Computer-Aided-Validation-Laboratory/halleffectsensors/hardware/circuit_picture_2.jpeg

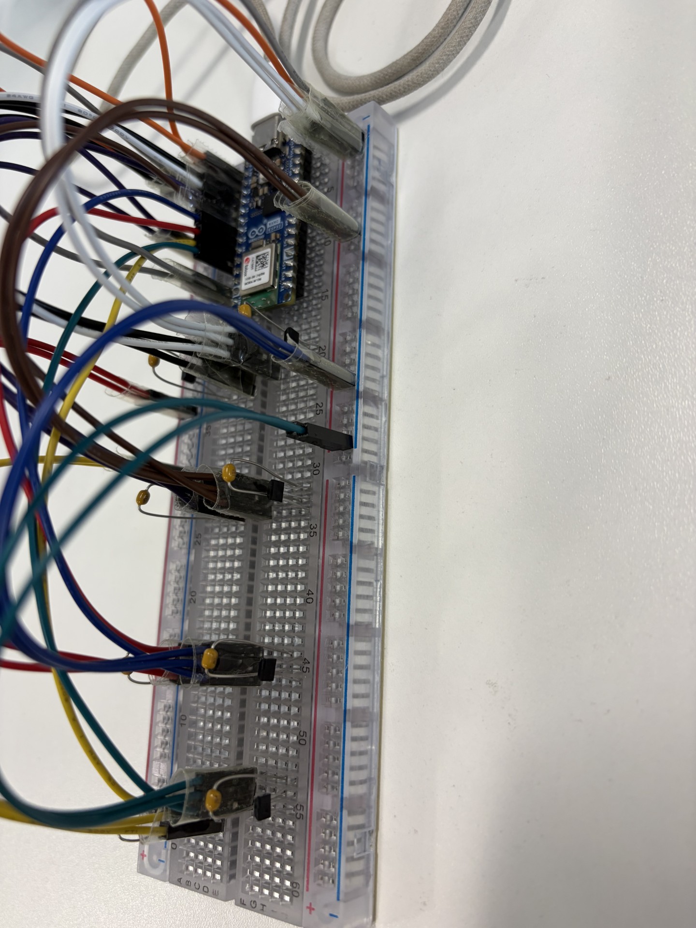
hardware/circuit_picture_2.jpeg
