Computer-Aided-Validation-Laboratory/halleffectsensors/hardware/circuit_picture_1.jpeg

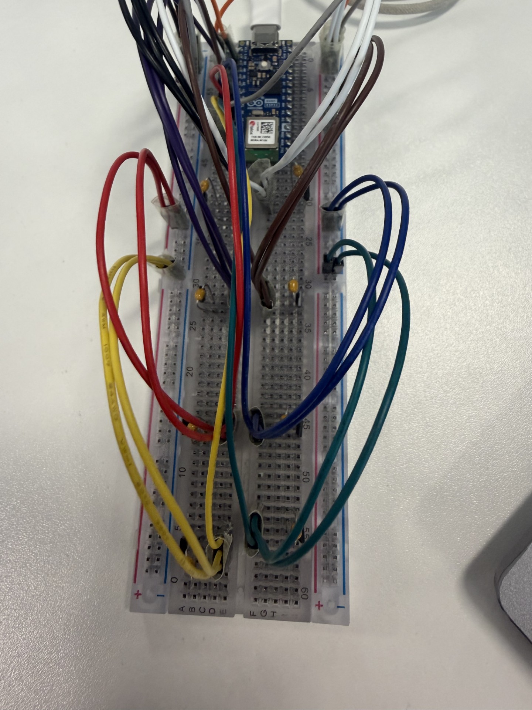
hardware/circuit_picture_1.jpeg
