Computer-Aided-Validation-Laboratory/halleffectsensors/software/interpolation_methods/overview.md

# Interpolation Methods

The field will eventually be visualised using a live feed from a National Instruments (NI) Data Aquisition (DAQ) system feeding into MatchID. In the mean time the fields used for calibration and otherwise are being visualised in python using the `griddata()` method from `scipy.interpolate` to interpolate the points. This not currently an exact method however just works to check the software is interpreting the sensor data and the coordinates of the sensors from the jsons correctly. 

The code for this is found in `plot.py` and it will produce an .mp4 file showing the field distribution across the sensor array. This method uses a cubic interpolation.
