Computer-Aided-Validation-Laboratory/halleffectsensors/hardware/circuit_design/intial_circuit.md

# Initial Circuit Design

The array must start with only a few sensors all facing in 1 direction. The initial array is put together using the sensors and capacitors and an Arduino Nano on a breadboard. This array is used to develop and validate calibration software which can be used on the extended array when it is made.

## Initial circuit schematic



This basic idea is scaled up for larger arrays but the concept is consistent throughout any array
