Computer-Aided-Validation-Laboratory/halleffectsensors/hardware/circuit_design/PCB_designs.md

not on this yet but will put PCB thoughts in here
