Computer-Aided-Validation-Laboratory/halleffectsensors/software/src/python_code/3D_array/cal_9-sensor.png

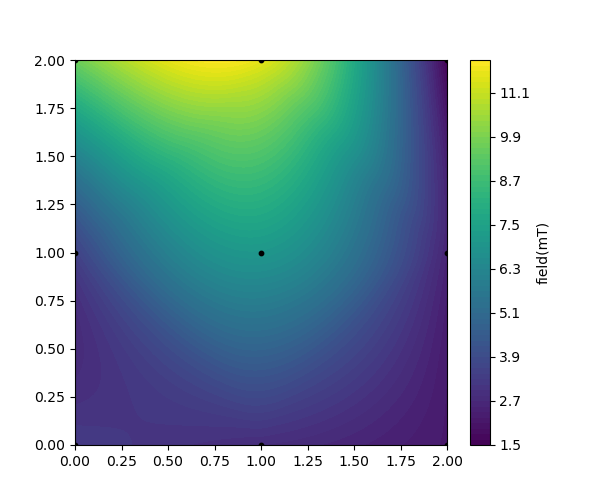
software/src/python_code/3D_array/cal_9-sensor.png
