Computer-Aided-Validation-Laboratory/halleffectsensors/software/src/python_code/3D_array/maps/cal_11-diff.png

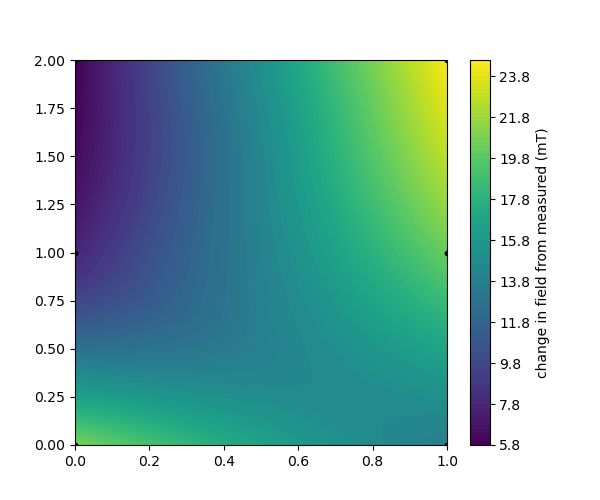
software/src/python_code/3D_array/maps/cal_11-diff.png
