Computer-Aided-Validation-Laboratory/halleffectsensors/software/src/python_code/example_plot.png

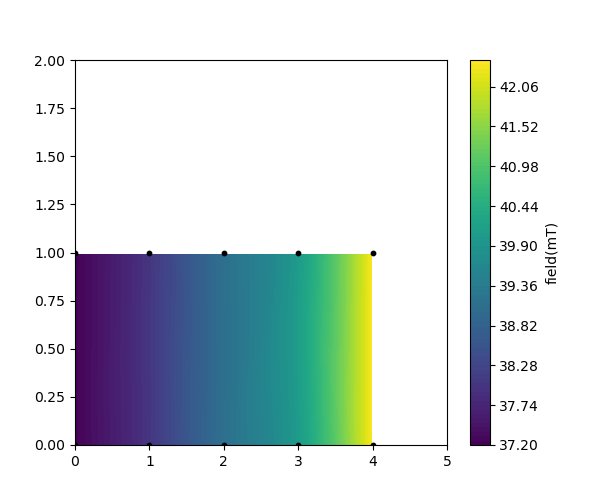
software/src/python_code/example_plot.png
