Computer-Aided-Validation-Laboratory/halleffectsensors/hardware/Sensor Array mesh.FCStd

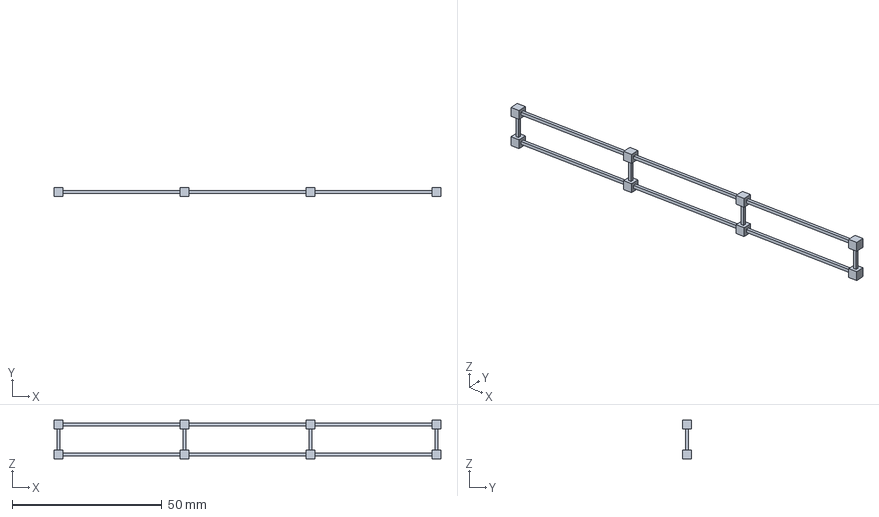
[picture p7: CAD file, 2026-10-21]
hardware/Sensor Array mesh.FCStd
129.1 x 3.00 x 13.0 mm
