Computer-Aided-Validation-Laboratory/halleffectsensors/hardware/cube.FCStd

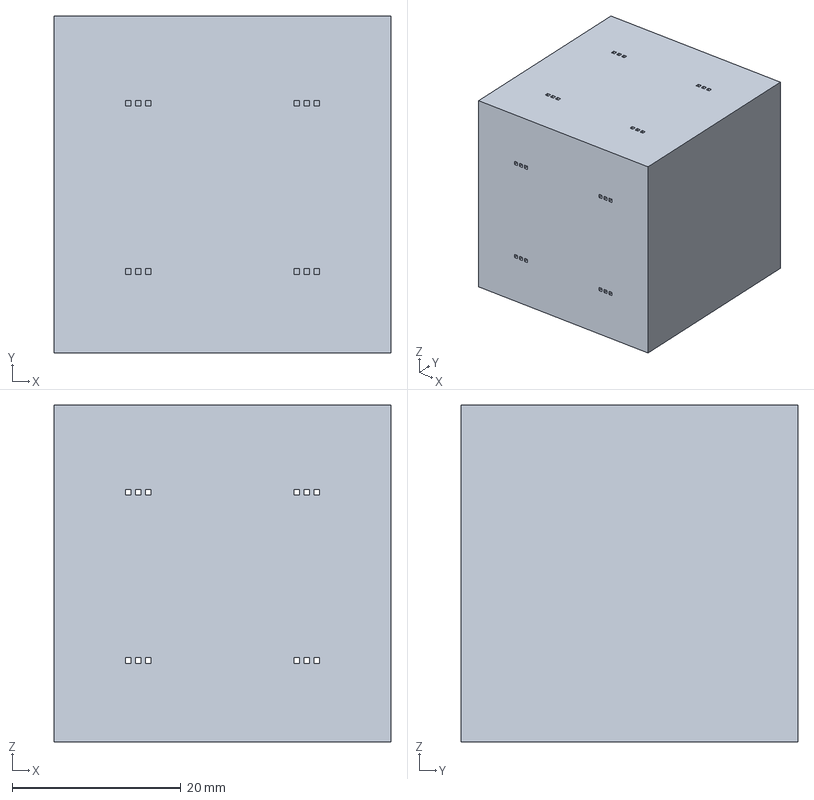
[picture p8: CAD file, 2026-10-21]
hardware/cube.FCStd
40.0 x 40.0 x 40.0 mm
