Computer-Aided-Validation-Laboratory/halleffectsensors/hardware/notches.FCStd

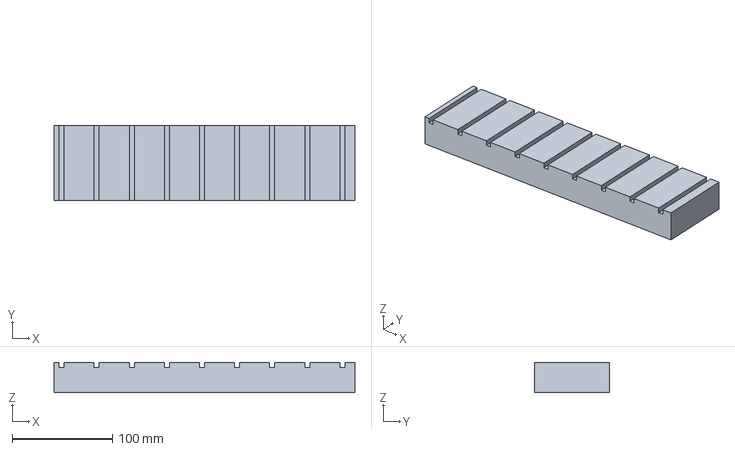
[picture p9: CAD file, 2026-10-21]
hardware/notches.FCStd
300.0 x 75.0 x 30.0 mm
