Computer-Aided-Validation-Laboratory/halleffectsensors/hardware/hall-sensors-storage.FCStd

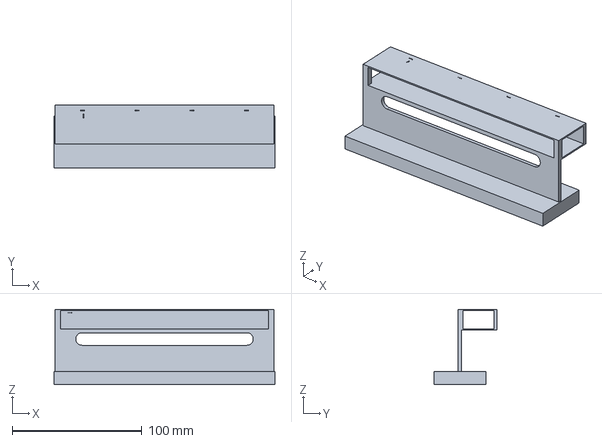
[picture p10: CAD file, 2026-10-21]
hardware/hall-sensors-storage.FCStd
170.0 x 48.8 x 58.0 mm
