Computer-Aided-Validation-Laboratory/halleffectsensors/hardware/new_shelf.FCStd

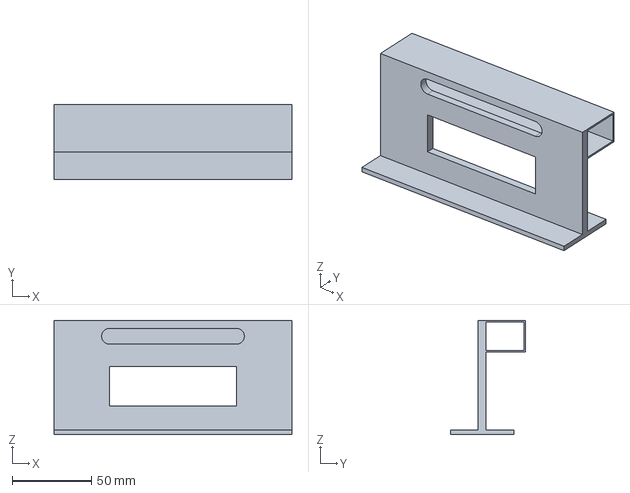
[picture p11: CAD file, 2026-10-21]
hardware/new_shelf.FCStd
150.0 x 47.5 x 72.0 mm
