Computer-Aided-Validation-Laboratory/halleffectsensors/hardware/Mini-Mera_setup_CAD.FCStd

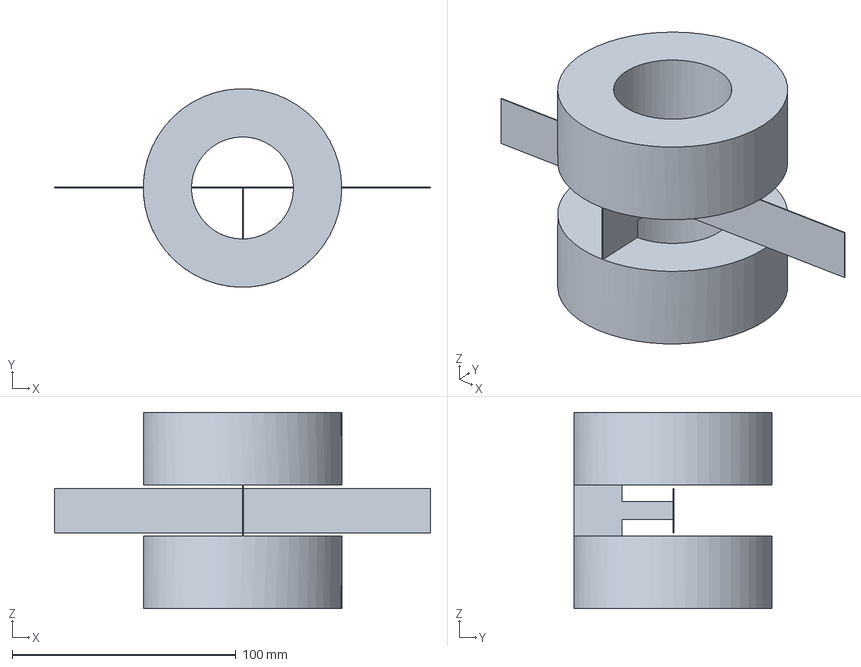
[picture p12: CAD file, 2026-10-21]
hardware/Mini-Mera_setup_CAD.FCStd
168.1 x 88.7 x 87.7 mm
