Computer-Aided-Validation-Laboratory/halleffectsensors/hardware/sensor_array_on_back.FCStd

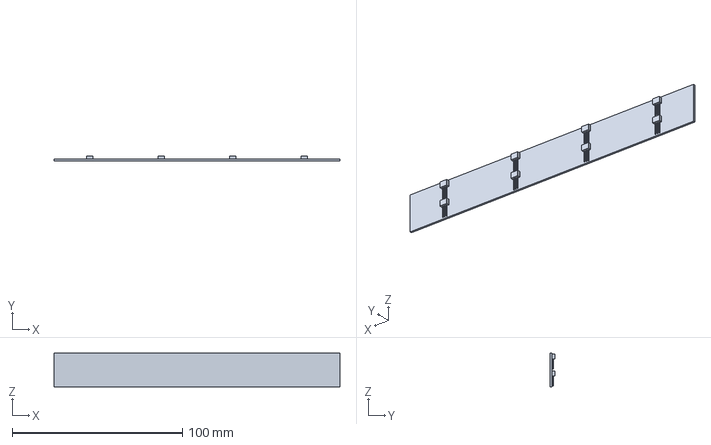
[picture p13: CAD file, 2026-10-21]
hardware/sensor_array_on_back.FCStd
168.1 x 2.65 x 19.9 mm
