Computer-Aided-Validation-Laboratory/halleffectsensors/hardware/sensor_board.FCStd

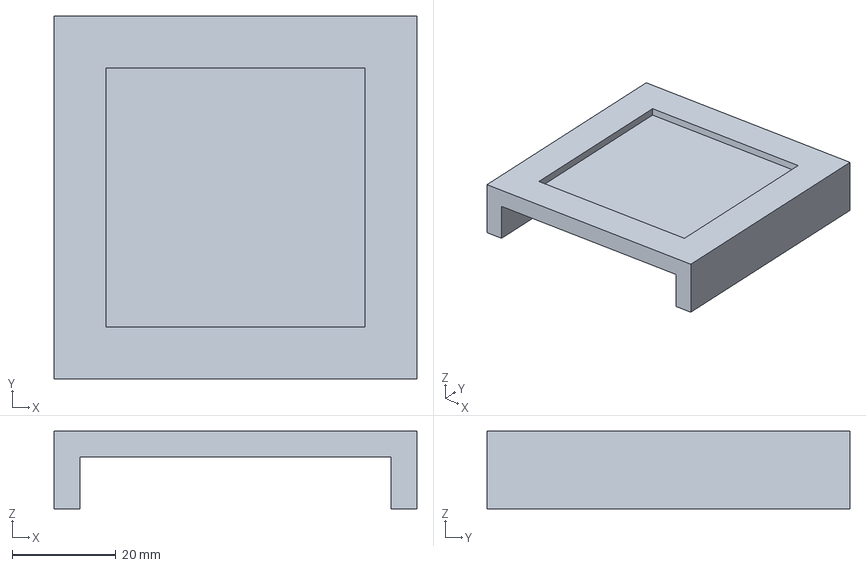
[picture p14: CAD file, 2026-10-21]
hardware/sensor_board.FCStd
70.0 x 70.0 x 15.0 mm
