Computer-Aided-Validation-Laboratory/halleffectsensors/hardware/calibration_tests.md

keep a log of the calibration tests done so far (what magnets were used, how did the test go, what setup was being calibrated and what results tell me, etc...)

so far done two, the FUJUKEN one that didnt really work and the Mini-mera one that also didnt work

and then do calibration technique plans moving forward
