Computer-Aided-Validation-Laboratory/halleffectsensors/software/src/python_code/1D_array/nulls.py

''' calculates the null voltage, associated uncertainty and the standard deviation of
each sensor in the array'''

from pathlib import Path
import numpy as np
import pandas as pd
from read import read_data

class Nulls:
    '''
    class for calculating the null voltage, standard deviations and associated uncertainties of each sensor
    measurements. 

    Attributes:
        number (int): the number of sensors in the array
        port (str): the computer port that the array is connected to
        vcc (float): the value of the VCC of the Arduino
        filename (str): the name that the data will be stored under
        vcc_un (float): the associated uncertainty with the reading of the vcc of the Arduino
        bits (int): the bit depth of the microcontroller
        samples (int): how many samples are read to get the values for null voltage and standard deviation

    Methods:
        find_params() -> None: 
            reads in the data and calculates the standard deviation of each sensor
            as well as the null voltages
        find_uncertainties_in_null() -> None:
            calculates the uncertainty associated with each calculation for null voltage
            that was just done.
        save_values() -> None:
            saves null voltages, uncertainties and standard deviations in csvs so that they can be 
            accessed for the next calibration step and for data conversion.
    '''
    def __init__(self, number: int, port: str, vcc: float,
                filename: str, vcc_un: float, bits: int, samples: int = 400):
        self.number = number
        self.port = port
        self.vcc = vcc
        self.vcc_uncertainty = vcc_un
        self.bits = bits
        self.filename = filename
        self.samples = samples

        self.levels = ((2**self.bits)-1)

        self.calibration_df = None
        self.null_values = None
        self.stds = None
        self.uncertainties_in_null = None
        self.null_frame = None
        self.std_frame = None

        self.find_params()

    def find_params(self) -> None:
        '''
        reads in the data and calculates the standard deviation of each sensor
        as well as the null voltages
        Args:
            None
        Returns:
            None
        '''

        self.calibration_df = read_data(self.port, self.filename, self.samples)
        self.null_frame = pd.DataFrame(np.zeros((2, self.number)), dtype = float)
        self.null_values = [0]*self.number
        self.stds = [0]*self.number

        for i in range(self.number):
            mean_entry = (self.calibration_df[self.calibration_df.columns[i+1]]).mean()
            self.null_values[i] = mean_entry * self.vcc / self.levels
            self.stds[i] = (self.calibration_df[self.calibration_df.columns[i+1]]).std(ddof=1)

        self.find_uncertainties_in_null()

    def find_uncertainties_in_null(self)-> None:
        '''
        this method calculates the uncertainty in each measurement of the null voltage
        Args:
            None
        Returns:
            None
        '''
        self.uncertainties_in_null = [0]*self.number
        count_uncertainty = 1
        uncertainty_in_vcc = (self.vcc_uncertainty/self.vcc)**2
        uncertainty_in_bits = (1/(self.levels/2))

        for i in range(self.number):
            average_sensor_reading = (self.calibration_df[self.calibration_df.columns[i+1]]).mean()
            uncertainty_in_reading = ((np.sqrt((count_uncertainty)**2+(self.stds[i])**2))/average_sensor_reading)**2
            rooted = np.sqrt(uncertainty_in_reading+uncertainty_in_vcc+(uncertainty_in_bits**2))
            self.uncertainties_in_null[i] = (rooted*self.null_values[i])

        self.save_values()

    def save_values(self) -> None:
        '''
        this method stores the values of the null voltages and their uncertainties
        as well as the values of the standard deviation of each sensor.
        Args:
            None
        Returns:
            None
        '''
        self.null_frame.iloc[0] = self.null_values
        self.null_frame.iloc[1] = self.uncertainties_in_null

        self.std_frame = pd.DataFrame(np.zeros((1, self.number)), dtype = float)
        self.std_frame.iloc[0] = self.stds

        file_dir = (Path(__file__).parent)
        output_file_nulls = file_dir/'nulls.csv'
        output_file_stds = file_dir/'stds.csv'

        self.null_frame.to_csv(output_file_nulls, index = False)
        self.std_frame.to_csv(output_file_stds, index = False)

if __name__ == "__main__":
    x = Nulls(number = 6 ,port = '/dev/ttyUSB0', vcc = 6.144,
          filename = 'nulls_1_new_circuit.csv', vcc_un = 0.005, bits = 15, samples = 400)
