Computer-Aided-Validation-Laboratory/halleffectsensors/software/src/python_code/3D_array/func.py

'''reads the data in from the Arduino'''
import json
import csv
from pathlib import Path
import time
import serial
import pandas as pd
import numpy as np

def read_data(port: str, filename: str, samples: int = 400) -> None:
    '''
    method for reading data from the sensor array from the Arduino. uses the
    serial library to read in the data, opens a csv and stores the data in
    that csv.
    Args:
        port (str): the computer port that the sensor array is connected to
        filename (str): the name of the file that the data is stored under
        samples (int): how many data samples are read in
    Returns:
        None
    '''
    ser = serial.Serial(port, 115200)
    ser.reset_input_buffer()
    time.sleep(2)
    script_dir = Path(__file__).parent/'calib_data'
    csv_file = script_dir / filename

    with open(csv_file, 'w', newline = '', encoding = 'utf-8') as csvfile:
        writer = csv.writer(csvfile)

        while True:
            raw = ser.readline().decode("utf-8", errors="ignore").strip()

            if "time_ms" in raw:
                header = raw
                break

        header = header[header.find("time_ms"):]
        header = header.replace('\x00', '').strip()
        writer.writerow(header.split(","))

        samples_taken = 0

        while samples_taken < samples:
            line = ser.readline().decode().strip()
            if line:
                values = line.split(',')
                writer.writerow(values)
                print(values)

                samples_taken += 1

    ser.close()

    df = pd.read_csv(csv_file, skipinitialspace=True)
    return df

def split_data(port: str, filename: str, samples: int, input_json: json) -> pd.DataFrame:
    '''
    method that imports a json file containing the information about each sensor. uses
    this information to sort through the columns of the incoming data and separate it
    depending on the direction the sensor faced (found in the .json). Runs the method
    above (`read_data`) so that when this method is called both will run
    Args:
        port (str): the computer port that the sensor array is connected to
        filename (str): the name of the csv file that the data that is read in is
            stored in
        samples (int): the number of samples taken
        input_json (json): contains all the input information of the sensor array being used
    Returns:
        x_data (pd.DataFrame): the data frame containing all the data coming in from
            sensors facing in the 'x' direction
        y_data (pd.DataFrame):the data frame containing all the data coming in from
            sensors facing in the 'y' direction
        z_data (pd.DataFrame):the data frame containing all the data coming in from
            sensors facing in the 'z' direction
        num_x (int): the number of sensors in the array facing the 'x' direction
        num_y (int): the number of sensors in the array facing the 'y' direction
        num_z (int): the number of sensors in the array facing the 'z' direction
    '''

    path_json = Path(__file__).parent
    output_json = path_json/input_json

    with open(output_json, encoding = 'utf-8') as f:
        sensor_data = json.load(f)

    # print(sensor_data)

    #total_input_df = read_data(port, filename, samples)
    data_path =  Path(__file__).parent /'calib_data'/filename
    total_input_df = pd.read_csv(data_path)
    rows = total_input_df.shape[0]

    num_x = 0
    num_y = 0
    num_z = 0

    for sensor in sensor_data["sensors"]:
        if sensor["direction"] == "x":
            num_x+=1
        elif sensor["direction"] == "y":
            num_y +=1
        elif sensor["direction"] == "z":
            num_z +=1
        else:
            print("direction error, check .json")

    x_data = pd.DataFrame(np.zeros((rows, (num_x+1))), dtype = float)
    x_data[x_data.columns[0]] = total_input_df[total_input_df.columns[0]]
    new_cols = ['time_ms']
    new_cols.extend([f'x_sensor_{i}' for i in range(1, num_x+1)])
    x_data.columns = new_cols

    y_data = pd.DataFrame(np.zeros((rows, (num_y+1))), dtype = float)
    y_data[y_data.columns[0]] = total_input_df[total_input_df.columns[0]]
    new_cols = ['time_ms']
    new_cols.extend([f'y_sensor_{i}' for i in range(1, num_y+1)])
    y_data.columns = new_cols

    z_data = pd.DataFrame(np.zeros((rows, (num_z+1))), dtype = float)
    z_data[z_data.columns[0]] = total_input_df[total_input_df.columns[0]]
    new_cols = ['time_ms']
    new_cols.extend([f'z_sensor_{i}' for i in range(1, num_z+1)])
    z_data.columns = new_cols

    i = x = z = y = 0

    for sensor in sensor_data["sensors"]:
        i +=1
        if sensor["index"] == i:
            if sensor["direction"] == "x":
                x_data[x_data.columns[x+1]] = total_input_df[total_input_df.columns[i]]
                x+=1
            elif sensor["direction"] == "y":
                y_data[y_data.columns[y+1]] = total_input_df[total_input_df.columns[i]]
                y+=1
            elif sensor["direction"] == "z":
                z_data[z_data.columns[z+1]] = total_input_df[total_input_df.columns[i]]
                z+=1

    return x_data, y_data, z_data, num_x, num_y, num_z
