Computer-Aided-Validation-Laboratory/halleffectsensors/(commit log)

2026-10-14 okay, added 3D calib using a json file, code should work for any json file, with any number of sensors (as long as divisible by 3, can add so that this doesnt need to be the case. Have done the nulls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
2026-10-15 need to start doing the docstrings for the 3D calibration script
2026-10-15 need to do them for sensors.py as well - not sure how useful it will be but will probably be fine
2026-10-16 added all the docstrings (now need to do current comparison for x,y,z coils) also want to do the finding how mmany of each sensor there are and saving them, will do that in the method and return them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
2026-10-16 added the docstrings and the current comparison method - going to add the counting of each sensor now and change that everywhere
2026-10-16 okay great so the numbering is done - there can now be uneven numbers of x, y, z sensors
2026-10-21 Add initial thoughts for PCB designs
2026-10-21 Create overview.md for interpolation methods
    Add overview for interpolation methods and data frames.
2026-10-21 added heat maps for visualising the calibration data - lowkey still bad - improve tomorrow
2026-10-25 Revise software overview for accuracy
    Updated the software overview to reflect current information and removed outdated content.
2026-10-25 Enhance software overview with detailed descriptions
    Updated the software overview to provide detailed explanations of the Arduino and Python code functionalities, including calibration methods and data processing.
2026-10-25 update overview .md
    Expanded the overview of calibration processes and key classes/methods in the documentation.
2026-10-26 put coordinate format in
    Clarify the format for sensor coordinates in the JSON file.
2026-10-26 Fix typo and add calibration document reference in README
    Corrected a typo in the README regarding the term 'fields' and added a reference to the calibration procedure document.
2026-10-26 Update and rename calibration_tests.md to calibration.md
2026-10-26 Enhance README with sensor details and resource links
    Expanded the README to include detailed explanations of sensor functionality and links to specific hardware resources.
2026-10-26 Revise README for calibration and JSON usage
    Updated calibration instructions and clarified usage of JSON files for sensor arrays.
2026-10-26 Fix typo and add 'etc' to calibration guidelines
2026-10-26 Fix formatting of grove cables entry in equipment list
2026-10-26 deleting arduino codes
2026-10-27 Fix equations for voltage uncertainty in project_background.md
    Corrected mathematical equations for null voltage uncertainty and field strength uncertainty calculations.
2026-10-28 BOOM, got a saved working field map of calibration results, will use this on tomorrows results too!
2026-10-28 Fix link to calibration instructions in README
    Updated calibration instructions link in README.md.
2026-11-04 fixed the 3D calibration to work if there is only 1 or 2 field directions being calibrated - won't crash anymore, fixed the plotting code as well
2026-11-04 changed image to one usign actual data from calibration
2026-11-06 Revise sensor array design specifications
    Updated the design description to allow for 24 sensors arranged in 8 rows across 3 directions.
2026-11-06 rejigged the arduino codes to just have two of them - also fixed the new one to include the A1 and A3 ports as well as the A0 and A2
